AlexandrRadulescu/ProiectareRoboti/Photos/Paralelipiped_intertie.png

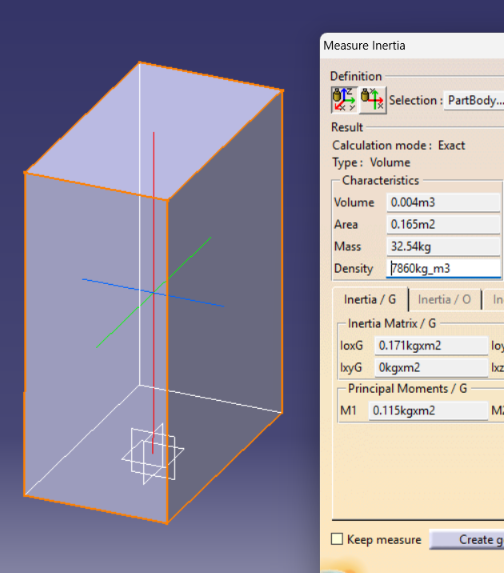
Photos/Paralelipiped_intertie.png
