AlexandrRadulescu/ProiectareRoboti/Objects/LINK_MODUL2/LINK_G_MR.step

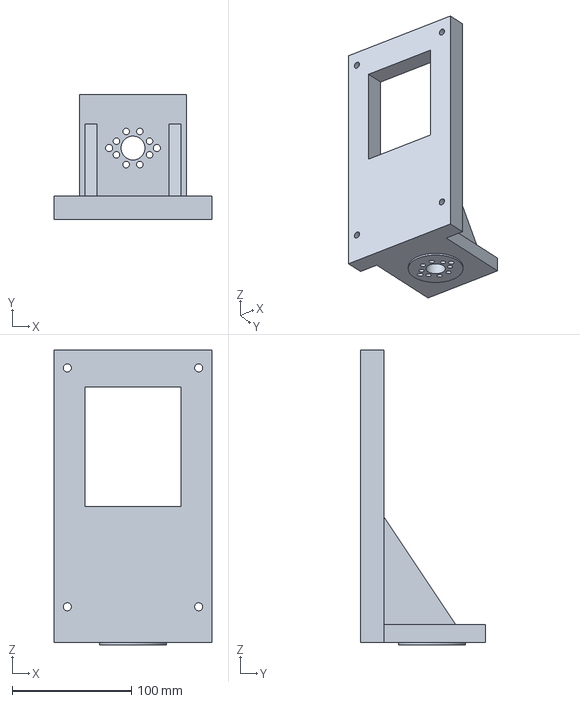
[picture p66: CAD file, 2026-11-08]
Objects/LINK_MODUL2/LINK_G_MR.step
132.0 x 105.0 x 247.0 mm
