AlexandrRadulescu/ProiectareRoboti/Objects/MODUL 2/COMPONENTE/CSG-32-XXX-2A-GR.stp

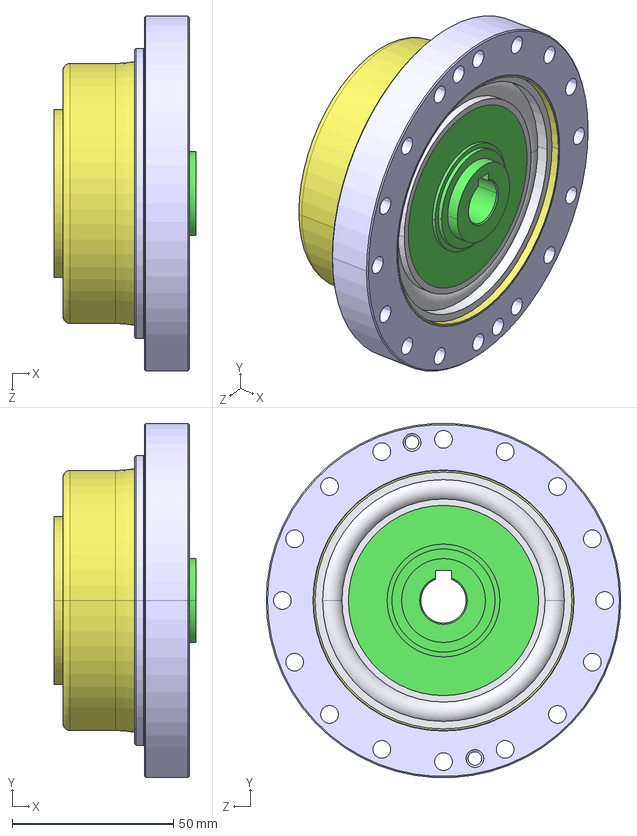
[picture p67: CAD file, 2026-11-08]
Objects/MODUL 2/COMPONENTE/CSG-32-XXX-2A-GR.stp
44.0 x 109.8 x 110.0 mm
