AlexandrRadulescu/ProiectareRoboti/Objects/MODUL 2/R_MOBIL/R_MOBIL.stp

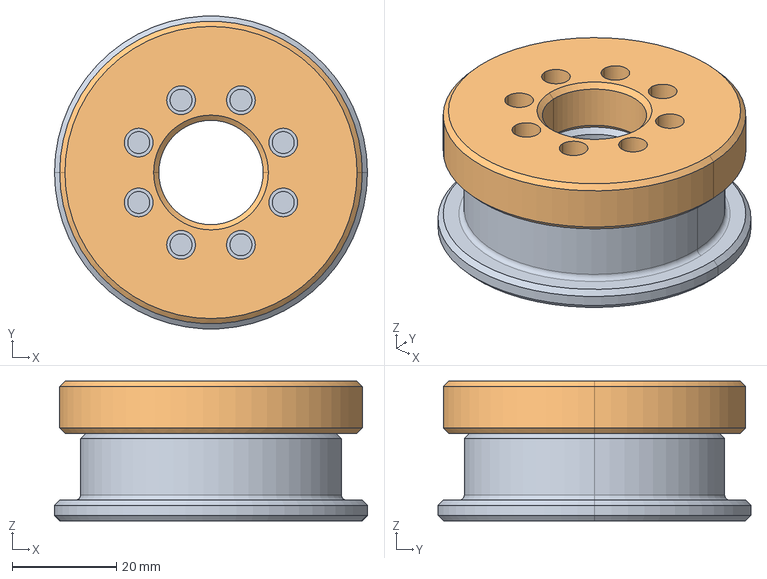
[picture p68: CAD file, 2026-11-13]
Objects/MODUL 2/R_MOBIL/R_MOBIL.stp
60.0 x 59.9 x 26.8 mm
