AlexandrRadulescu/ProiectareRoboti/Objects/MODUL 2/R_STABIL/R_STABIL.stp

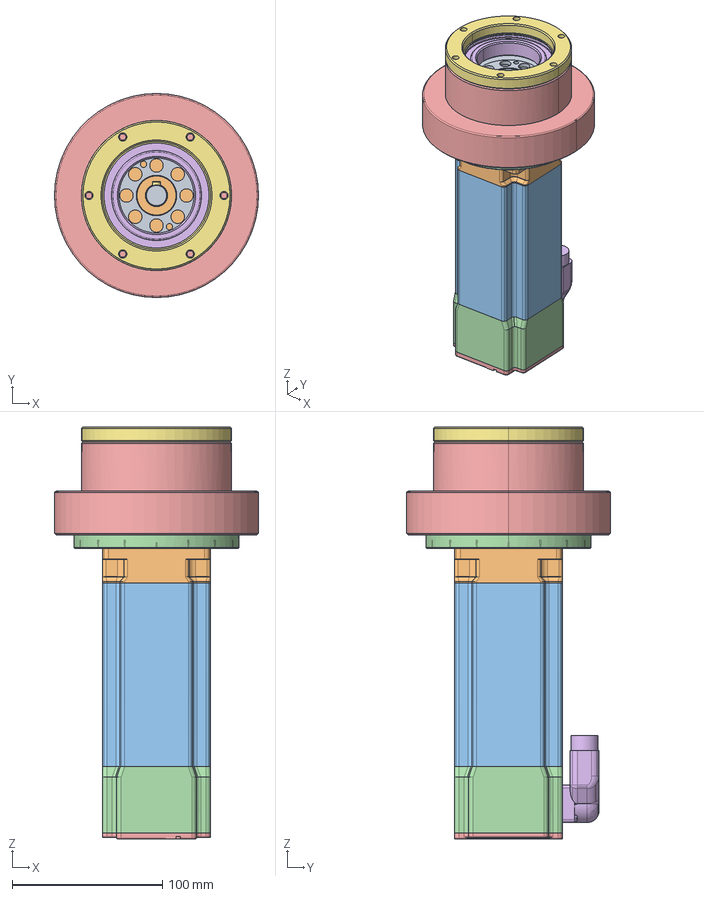
[picture p69: CAD file, 2026-11-13]
Objects/MODUL 2/R_STABIL/R_STABIL.stp
136.0 x 136.0 x 274.5 mm
