AlexandrRadulescu/ProiectareRoboti/Objects/Subansamblu_Gripper_fara_ob.stp

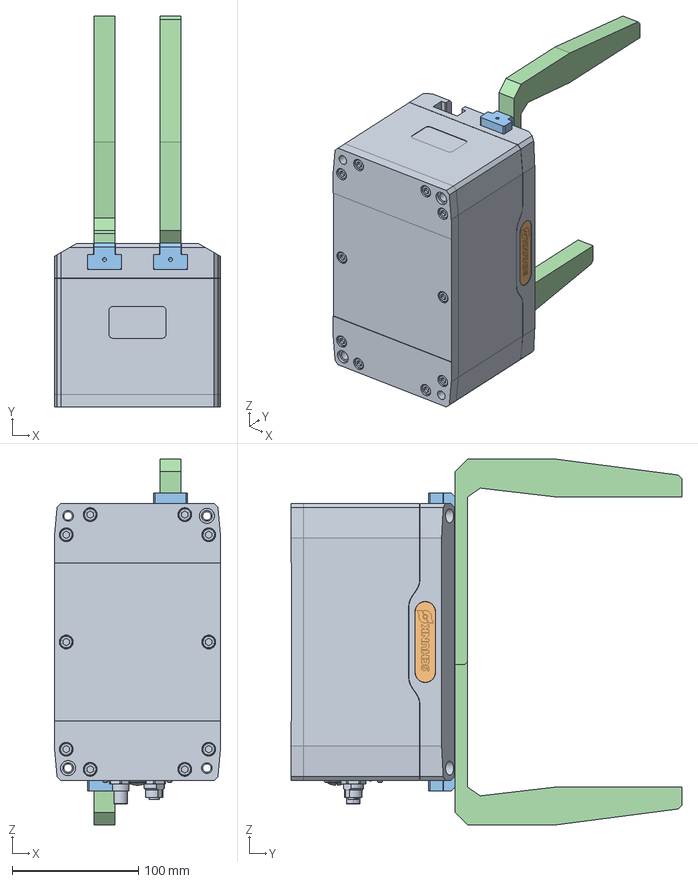
[picture p70: CAD file, 2026-10-28]
Objects/Subansamblu_Gripper_fara_ob.stp
132.0 x 310.0 x 290.0 mm
