AlexandrRadulescu/ProiectareRoboti/Objects/MODUL 2/COMPONENTE/Flansa_iesire_MR.step

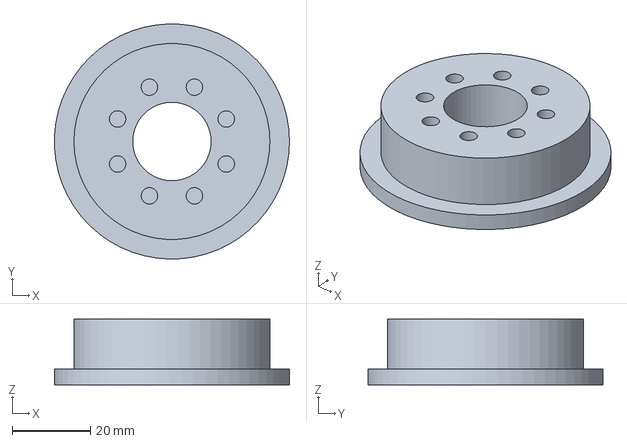
[picture p71: CAD file, 2026-11-08]
Objects/MODUL 2/COMPONENTE/Flansa_iesire_MR.step
60.0 x 60.0 x 16.8 mm
