AlexandrRadulescu/ProiectareRoboti/Objects/MODUL 2/COMPONENTE/AM8032-xx01.stp

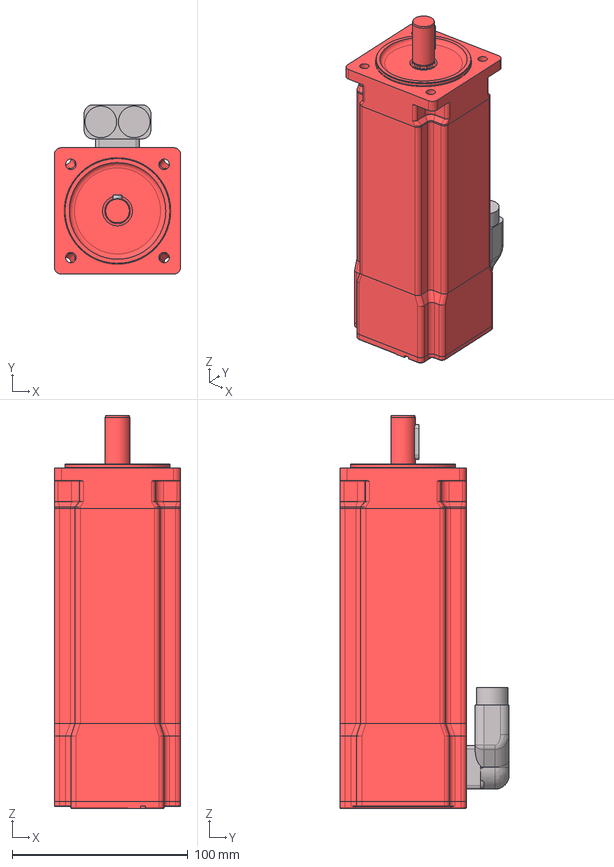
[picture p72: CAD file, 2026-11-08]
Objects/MODUL 2/COMPONENTE/AM8032-xx01.stp
72.0 x 96.4 x 223.7 mm
Volumenkörper2
Volumenkörper3
Volumenkörper4
Volumenkörper5
Volumenkörper6
Intercontec-EEDC101NN00000006000
DIN 6885-A5x5x20
