AlexandrRadulescu/ProiectareRoboti/Objects/MODUL 2/COMPONENTE/Capac_MR.step

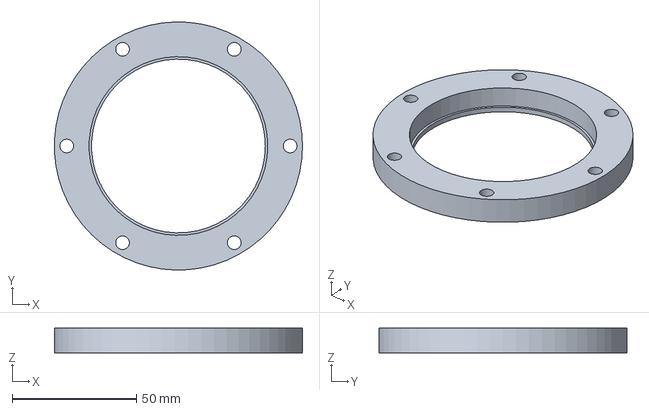
[picture p73: CAD file, 2026-11-08]
Objects/MODUL 2/COMPONENTE/Capac_MR.step
99.9 x 100.0 x 10.0 mm
