AlexandrRadulescu/ProiectareRoboti/Objects/MODUL 2/COMPONENTE/Flansa_adaptare_MR.step

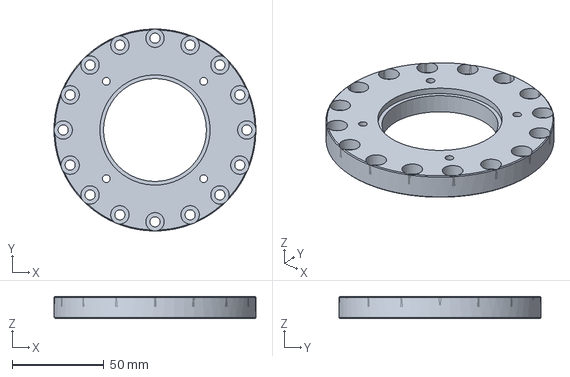
[picture p74: CAD file, 2026-11-08]
Objects/MODUL 2/COMPONENTE/Flansa_adaptare_MR.step
110.0 x 110.0 x 12.0 mm
