AlexandrRadulescu/ProiectareRoboti/Objects/MODUL 2/COMPONENTE/Inel_fixare_MR.step

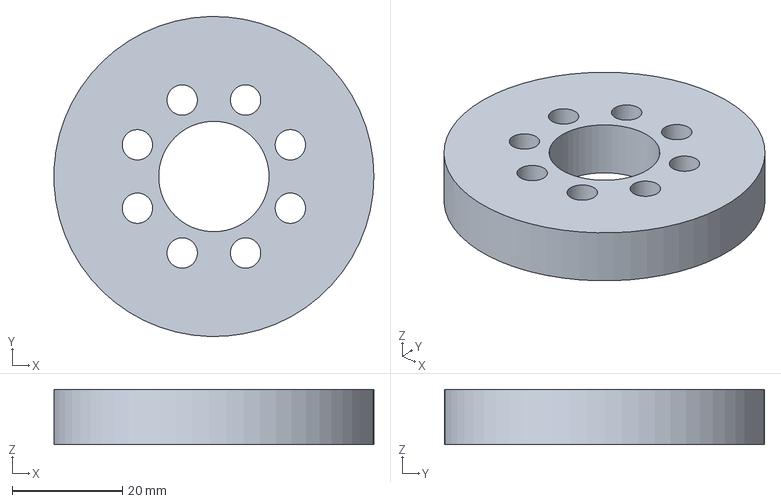
[picture p75: CAD file, 2026-11-08]
Objects/MODUL 2/COMPONENTE/Inel_fixare_MR.step
58.0 x 58.0 x 10.0 mm
