AlexandrRadulescu/ProiectareRoboti/Objects/MODUL 2/COMPONENTE/Carcasa_MR.step

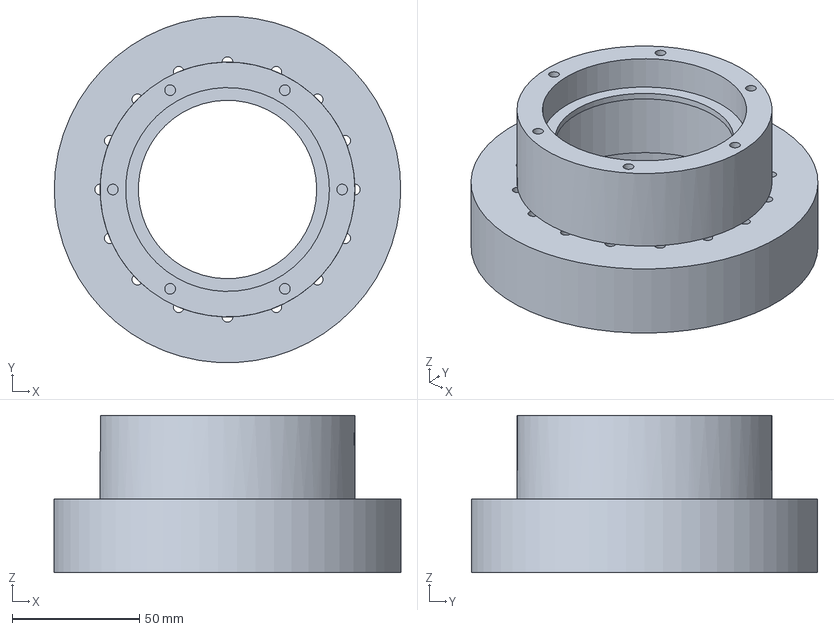
[picture p76: CAD file, 2026-11-08]
Objects/MODUL 2/COMPONENTE/Carcasa_MR.step
136.0 x 135.8 x 61.8 mm
