AlexandrRadulescu/ProiectareRoboti/(list of files, cad)

Other CAD files:
Objects/4.5_Proiectare_Robot.CATProduct
Objects/Bacuri.CATPart
Objects/FULL/ROBOT.CATProduct
Objects/Gripper/CATIAV5/SCHUNK-1496203 EGU 80.CATPart
Objects/Gripper/CATIAV5/SCHUNK-9957615 Typenschild 16x64x0.3.CATPart
Objects/Gripper/CATIAV5/SCHUNK-Dummy 1491586 EGU 80-PN-M-B,000ohne0.CATPart
Objects/Gripper/CATIAV5/SCHUNK-Gehaeuse EGU 80 PN_EI 04140.CATPart
Objects/Gripper/CATIAV5/SCHUNK_1491586_EGU_80_PN_M_B_000ohne0.catproduct
Objects/LINK_MODUL2/LINK_G_MR.CATPart
Objects/Links/Base.CATPart
Objects/Links/Cot.CATPart
Objects/Links/Cot_Gripper.CATPart
Objects/Links/R/R.CATProduct
Objects/Links/R/R_Base.CATPart
Objects/Links/R/R_Rot.CATPart
Objects/Links/T/T.CATProduct
Objects/Links/T/T_Cil.CATPart
Objects/Links/T/T_Prisma.CATPart
Objects/MODUL 2/COMPONENTE/AM8032-xx01.CATProduct
Objects/MODUL 2/COMPONENTE/CSG-32-XXX-2A-GR.CATPart
Objects/MODUL 2/COMPONENTE/DIN 6885-A5x5x20.CATPart
Objects/MODUL 2/COMPONENTE/Intercontec-EEDC101NN00000006000.CATPart
Objects/MODUL 2/COMPONENTE/Rulment_R.CATPart
Objects/MODUL 2/COMPONENTE/_NPart#360.CATPart
Objects/MODUL 2/COMPONENTE/_NPart#5552.CATPart
Objects/MODUL 2/COMPONENTE/_NPart#6464.CATPart
Objects/MODUL 2/COMPONENTE/_NPart#8132.CATPart
Objects/MODUL 2/COMPONENTE/_NPart#86.CATPart
Objects/MODUL 2/Capac_MR.CATPart
Objects/MODUL 2/Carcasa.CATPart
Objects/MODUL 2/Flansa_adaptare_MR.CATPart
Objects/MODUL 2/Inel_fixare_MR.CATPart
Objects/MODUL 2/Modul_R.CATProduct
Objects/MODUL 2/Part19.CATPart
Objects/MODUL 2/R_MOBIL/R_MOBIL.CATProduct
Objects/MODUL 2/R_STABIL/R_STABIL.CATProduct
Objects/Paralelipiped.CATPart
Objects/Paralelipiped.CATPart.CATProduct
Objects/Subansamblu_Gripper.CATProduct
