AlexandrRadulescu/ProiectareRoboti/(commit log)

2026-10-25 [Viza 1] Un pic si din viza 2
    [Bacuri.CATPart, Base.CATPart, Cot.CATPart, Paralelipiped.CATPart, Paralelipiped.CATPart.CATProduct, R_Base.CATPart, R_Rot.CATPart, SCHUNK-1496203 EGU 80.CATPart]
2026-10-25 [Viza 2.0] Adaugat model 3D si refacut proportii
    [4.5_Proiectare_Robot.CATProduct, Base.CATPart, Cot.CATPart, Cot_Gripper.CATPart, R.CATProduct, R_Base.CATPart, R_Rot.CATPart, T.CATProduct]
2026-10-28 [Viza 2.1] Model MATLAB + Memoriu update
    [Subansamblu_Gripper.CATProduct, Subansamblu_Gripper_fara_ob.stp]
2026-11-05 [Viza 2.6] FIX Am updatat valorile gresite si memoriul
    [Paralelipiped.CATPart]
2026-11-08 [Viza 3.0] Adaugat Modele 3D complexe pentru Modulul 2 + Documentatie
    [AM8032-xx01.CATProduct, AM8032-xx01.stp, CSG-32-XXX-2A-GR.CATPart, CSG-32-XXX-2A-GR.stp, Capac_MR.CATPart, Capac_MR.step, Carcasa.CATPart, Carcasa_MR.step]
2026-11-13 [Viza 3.3] Added MATLAB models and inertia TODO calculate max forces/moments
    [Flansa_adaptare_MR.CATPart, Modul_R.CATProduct, R_MOBIL.CATProduct, R_MOBIL.stp, R_STABIL.CATProduct, R_STABIL.stp]
